icefoxj/OutageAlarm/hardware/mechanical/3mf/enclosure_sides_2color.3mf

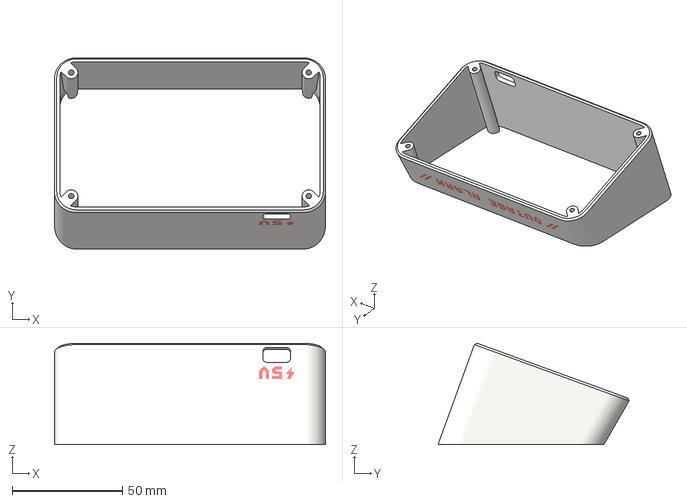
[picture p12: CAD file, 2026-11-11]
hardware/mechanical/3mf/enclosure_sides_2color.3mf
122.8 x 86.6 x 46.0 mm
