icefoxj/OutageAlarm/hardware/mechanical/stl/enclosure_top.stl

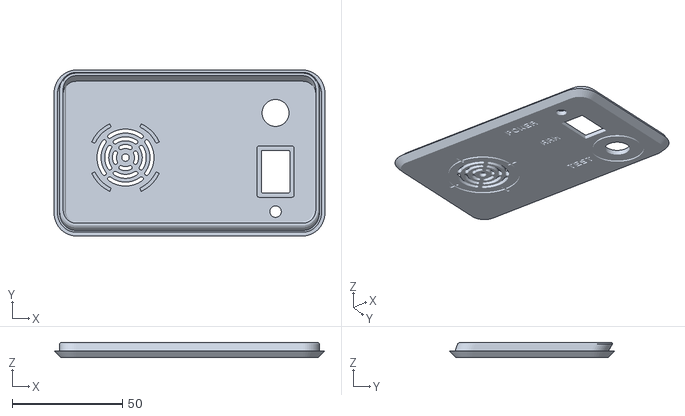
[picture p13: CAD file, 2026-11-11]
hardware/mechanical/stl/enclosure_top.stl
122.8 x 75.2 x 6.76
