icefoxj/OutageAlarm/hardware/mechanical/3mf/enclosure_top_2color.3mf

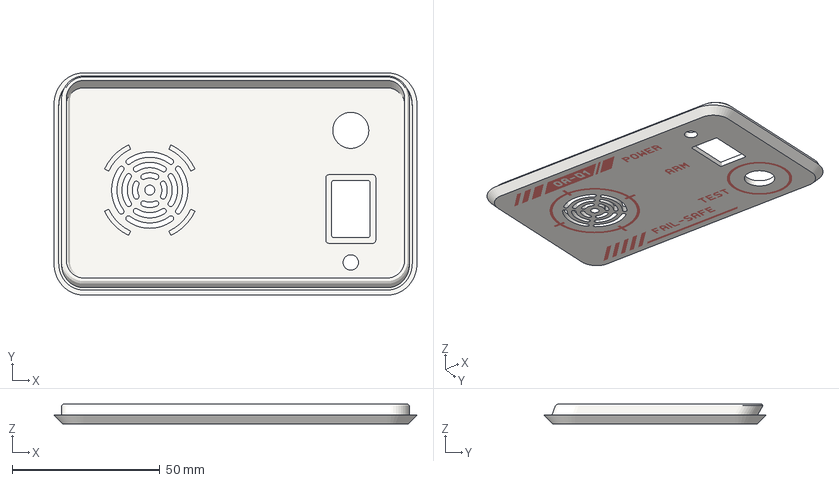
[picture p14: CAD file, 2026-11-11]
hardware/mechanical/3mf/enclosure_top_2color.3mf
122.8 x 75.2 x 6.76 mm
