icefoxj/OutageAlarm/hardware/mechanical/stl/enclosure_sides.stl

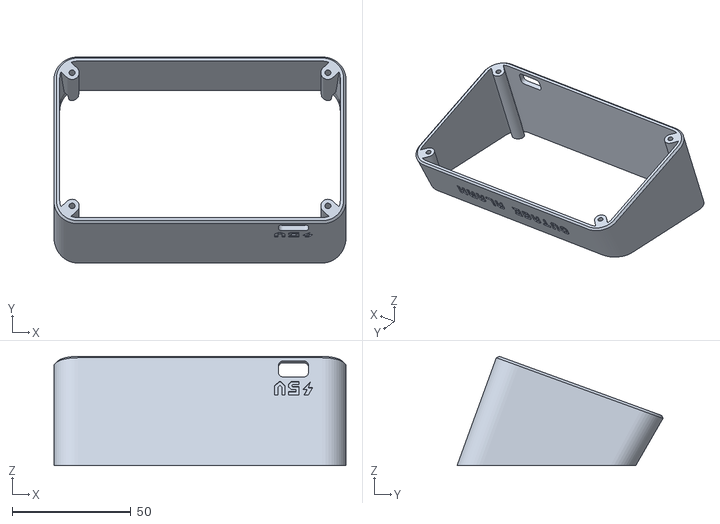
[picture p15: CAD file, 2026-11-11]
hardware/mechanical/stl/enclosure_sides.stl
122.8 x 86.6 x 46.0
