icefoxj/OutageAlarm/hardware/mechanical/stl/enclosure_base.stl

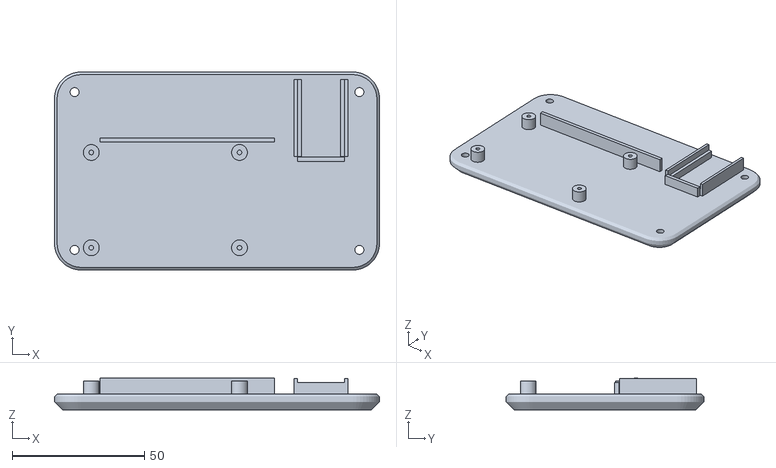
[picture p16: CAD file, 2026-11-11]
hardware/mechanical/stl/enclosure_base.stl
122.8 x 74.8 x 12.0
