icefoxj/OutageAlarm/(commit log)

2026-11-10 Cria projeto OutageAlarm v1: documentação, esquemático e caixa 3D
    - README com princípio de funcionamento, BOM, teste e roadmap
    - CLAUDE.md com contexto, princípios de projeto e convenções
    - Esquemático v1 (relé com contato NF, falha segura, sem microcontrolador)
    - Caixa paramétrica em OpenSCAD (base + tampa de encaixe)
    - CI que renderiza STLs e imagens da caixa
    [caixa.scad]
2026-11-10 Ajusta textos da caixa e atualiza o CI
    - Texto da tampa menor e centralizado (não passa mais da borda)
    - "ARMAR" à esquerda da chave, fora da área da alavanca
    - STL da tampa no mesmo quadrante da base
    - CI só roda quando o .scad muda; actions atualizadas
    - .gitattributes: STL e PNG como binários
    [caixa.scad]
2026-11-10 Troca a bateria 9 V por 18650 recarregável e adiciona botão TESTE
    - U1: módulo TP4056 USB-C com proteção mantém a bateria sempre carregada
    e passa a ser a entrada de energia (substitui a plaquinha USB-C)
    - BT1: Li-ion 18650; autonomia tocando passa de ~1 dia para vários dias
    - SW2: pulsador NF em série com a bobina de K1 simula a queda de energia
    e testa bateria, relé, chave e buzzer de uma vez
    - Caixa redesenhada: suporte 18650 atrás, TP4056 na parede direita,
    chave ARMAR e botão TESTE na frente
    - Esquemático, BOM, tabela de ligações, testes e CLAUDE.md atualizados
    [caixa.scad]
2026-11-10 Adiciona STLs e imagens renderizadas da caixa
    Gerados pelo workflow render-caixa a partir do caixa.scad atual.
    [caixa_base.stl, caixa_tampa.stl]
2026-11-10 Translate all project material to English
    - Docs, CLAUDE.md, schematic labels and OpenSCAD comments/identifiers in English
    - Engraved enclosure text: ARM, TEST, POWER, 5V
    - Rename files and folders: hardware/electronics/schematic.svg,
    hardware/mechanical/enclosure.scad, docs/electronics.md, docs/mechanical.md
    - Relay contacts named NC/NO; decimal point in values
    - CI workflow renamed to render-enclosure (artifact: enclosure-render)
    [caixa.scad, enclosure.scad, enclosure_base.stl, enclosure_lid.stl]
2026-11-10 Update rendered STLs and images with English engravings
    Generated by the render-enclosure workflow from the current enclosure.scad.
    [enclosure_base.stl, enclosure_lid.stl]
2026-11-11 Redesign the enclosure as a wedge on a floating base
    - Wedge-shaped shell: the control face tilts 20 degrees toward the user,
    the front leans back 10 degrees, 10 mm corner radius and a 45 degree
    chamfer around the face (prints without supports, face on the bed).
    - Dark 6 mm base with a 45 degree undercut, closed with 4 countersunk
    M3 screws from below into posts molded in the shell.
    - Slotted round speaker grille, a ring around TEST, labels, the
    "OutageAlarm" wordmark on the front and a bolt + 5V on the back.
    - ARM switch is now a KCD1-101 rocker (flush, snaps into the face).
    - USB-C moves to the back; the TP4056 cradle sits at the back right.
    - Clearance checks are now assert()s in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
    [enclosure.scad, enclosure_base.stl, enclosure_lid.stl, enclosure_shell.stl]
2026-11-11 Add a mech-style livery and a two-colour 3MF of the shell
    The shell now wears a livery in the style of anime mech markings, inlaid
    0.6 mm deep in a second filament:
    - a title band with speed dashes and the unit code "OA-01" cut out;
    - a reticle around the grille and a ring around TEST;
    - hazard stripes with "FAIL-SAFE";
    - "// OUTAGE ALARM //" on the front, and a bolt and "5V" on the back.
    All the lettering uses a chamfered straight-line stroke font drawn in the
    model (mech_glyphs).
    - enclosure.scad exports the recessed shell and three inlays (face, front,
    back). Each inlay is the outer solid intersected with its recess, so it
    fills the recess exactly. The one-colour shell keeps only the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
    [enclosure.scad, enclosure_shell.stl, enclosure_shell_2color.3mf]
2026-11-11 Split the shell into a top and sides, joined by a glued lip
    The shell is now two printed parts, so the two-colour top can print on its
    own: its whole livery is in the first 3 layers of a 6.8 mm print.
    - top: the control face and its chamfer, the buzzer ring, and a lip;
    - sides: the walls and the screw posts.
    The joint:
    - the seam runs along the crease under the face chamfer, where the shell
    already has an edge;
    - a 4 x 1.6 mm lip under the top fits inside the walls, with a 0.15 mm glue
    gap per side and a lead-in chamfer;
    - a groove in the top, over the inner edge of the walls, takes excess glue
    so it doesn't squeeze out of the seam;
    - the screw posts reach the seam, notched for the li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
    [enclosure.scad, enclosure_shell.stl, enclosure_shell_2color.3mf, enclosure_sides.stl, enclosure_sides_2color.3mf, enclosure_top.stl, enclosure_top_2color.3mf]
2026-11-11 Update the docs for the three-part enclosure and add a changelog for v1.0.0
    - README: three printed parts, exploded and joint views, a link to the
    release downloads and the changelog.
    - electronics.md: the relay goes 3 mm from the board's front edge, no
    closer, or it touches the top's lip.
    - mechanical.md: the base prints 12 mm tall; one-colour wording for the
    split parts; where to download the print files.
    - CLAUDE.md: the release process; CHANGELOG in the layout.
    - CHANGELOG.md: v1.0.0.
